eastmohan/keyboard/BOM.csv

KTT Kang White V3 Switches (70) | 1 | $18.53 | Aliexpress | https://www.aliexpress.us/item/3256805881801670.html?curPageLogUid=GlRH5qOW1IWp
1N4148 Diodes | 1 | $1.33 | Aliexpress | https://www.aliexpress.us/item/2255800939822415.html?curPageLogUid=RZOBB0uZmJXu
Keycap Stabilizers | 1 | $7.93 | Aliexpress | https://www.aliexpress.us/item/3256811775590309.html?curPageLogUid=WieDBUcBWX8g
PCB | 1 | $20.00 | JLCPCB | https://trade.jlcpcb.com/checkout/payMethod/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
Cherry Style Keycaps (any) | 1 |  | various
Raspberry Pi Pico 2 | 1 | $5.00 | PiShop | https://www.pishop.us/product/raspberry-pi-pico-2/
