eastmohan/keyboard/CAD/keyboard_assembled.step

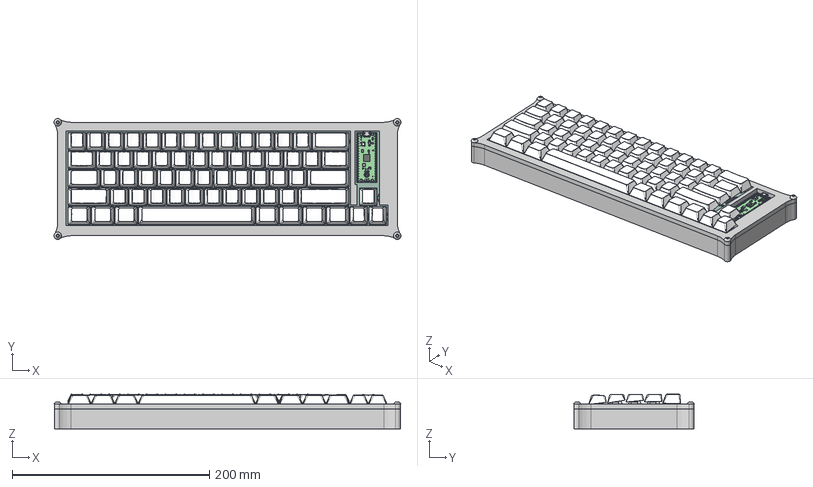
[picture p1: CAD file, 2026-10-19]
CAD/keyboard_assembled.step
351.8 x 122.5 x 35.2 mm
BHSBHCS ASME B18.3.4M - M4 x 0.7 x 25 Steel Grade 2 Plain x 4
FOEI - M3 X 5.74 Stainless Steel Plain x 4
