eastmohan/keyboard/CAD/Source Files/raspberry_pico_2.step

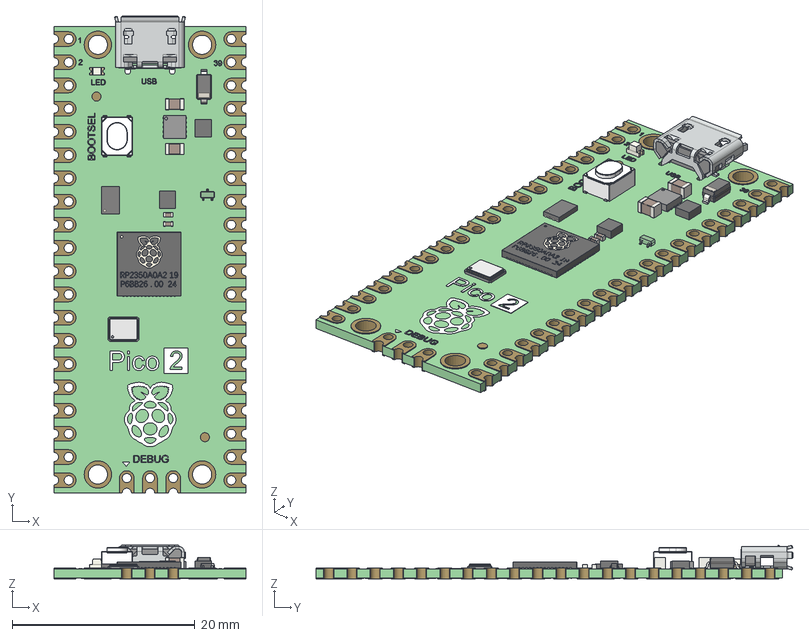
[picture p2: CAD file, 2026-10-19]
CAD/Source Files/raspberry_pico_2.step
21.0 x 52.1 x 3.70 mm
PCB
castel_hole x 40
castel_hole001 x 3
mounting_pad x 4
TP_noname001
test_point_round001
shield
socket_housing
socket_plate
terminal
terminal001
terminal002
terminal003
terminal004
LFXTAL055299Reel
LFXTAL055299Reel001
LFXTAL055299Reel002
LFXTAL055299Reel003
LFXTAL055299Reel004
LFXTAL055299Reel005
LFXTAL055299Reel006
LFXTAL055299Reel007
tactile_switch
Text_debug
fleche_debug
text_Pico
2_on_white
Text_led
Text_usb
Text_BOOTSEL
Text_1
Text_l2
Text_39
Scale003
Scale
ShapeString001
ShapeString002
ShapeString003
ShapeString004
ShapeString005
ShapeString006
ShapeString007
ShapeString008
ShapeString009
ShapeString010
ShapeString011
ShapeString
ShapeString013
ShapeString014
ShapeString015
ShapeString016
ShapeString017
ShapeString018
ShapeString019
ShapeString020
ShapeString021
ShapeString022
ShapeString023
D_SOD-123
ThermalPin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
