eastmohan/keyboard/CAD/Source Files/CHERRYMX CAD_CAM KEYCAPS.stp

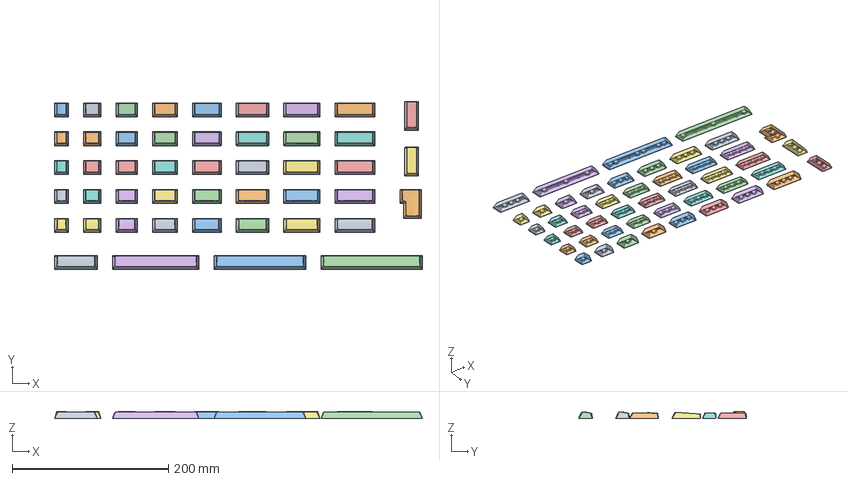
[picture p3: CAD file, 2026-10-19]
CAD/Source Files/CHERRYMX CAD_CAM KEYCAPS.stp
471.6 x 215.6 x 9.30 mm
