eastmohan/keyboard/CAD/top_plate.stl

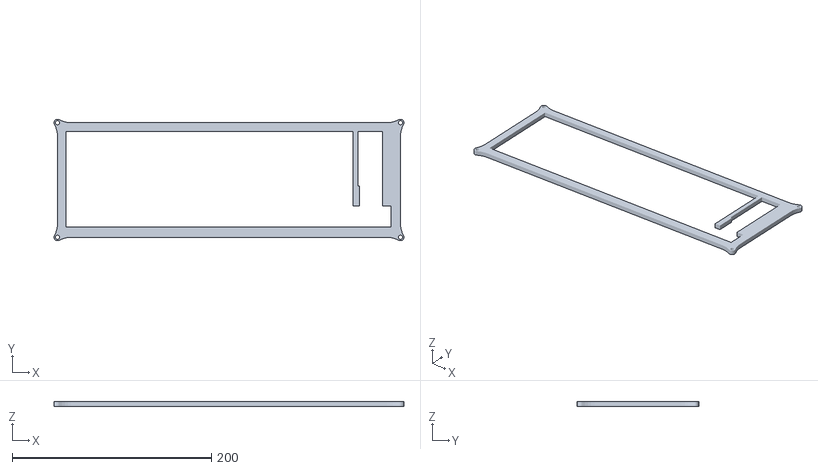
[picture p4: CAD file, 2026-10-19]
CAD/top_plate.stl
351.2 x 121.9 x 5.00
