eastmohan/keyboard/CAD/case_bottom.stl

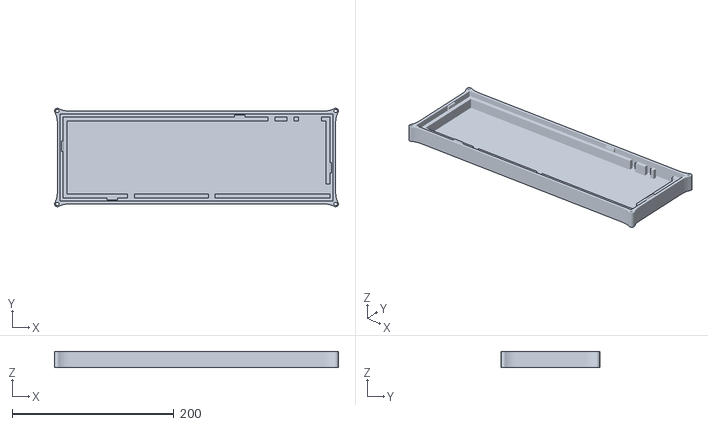
[picture p5: CAD file, 2026-10-19]
CAD/case_bottom.stl
351.2 x 121.9 x 20.2
