eastmohan/keyboard/CAD/keyboard_60.step

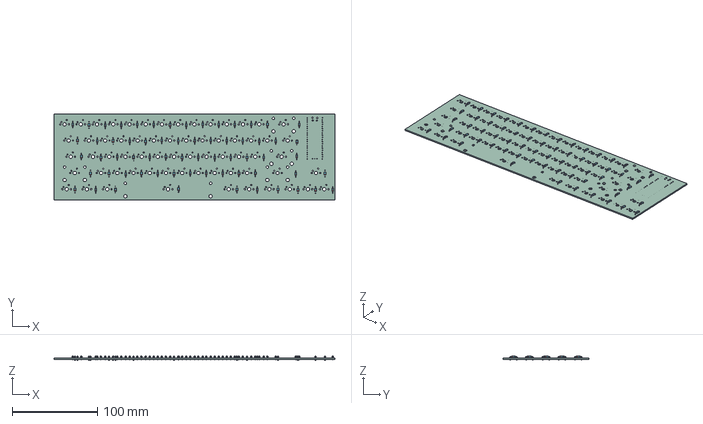
[picture p6: CAD file, 2026-10-13]
CAD/keyboard_60.step
330.0 x 100.8 x 5.01 mm
D_DO-35_SOD27_P7.62mm_Horizontal x 64
key7201_PCB
