eastmohan/keyboard/PCB/Project Files/keyboard_60.kicad_pcb

## KiCad design PCB/Project Files/keyboard_60.kicad_pcb (2026-10-12)

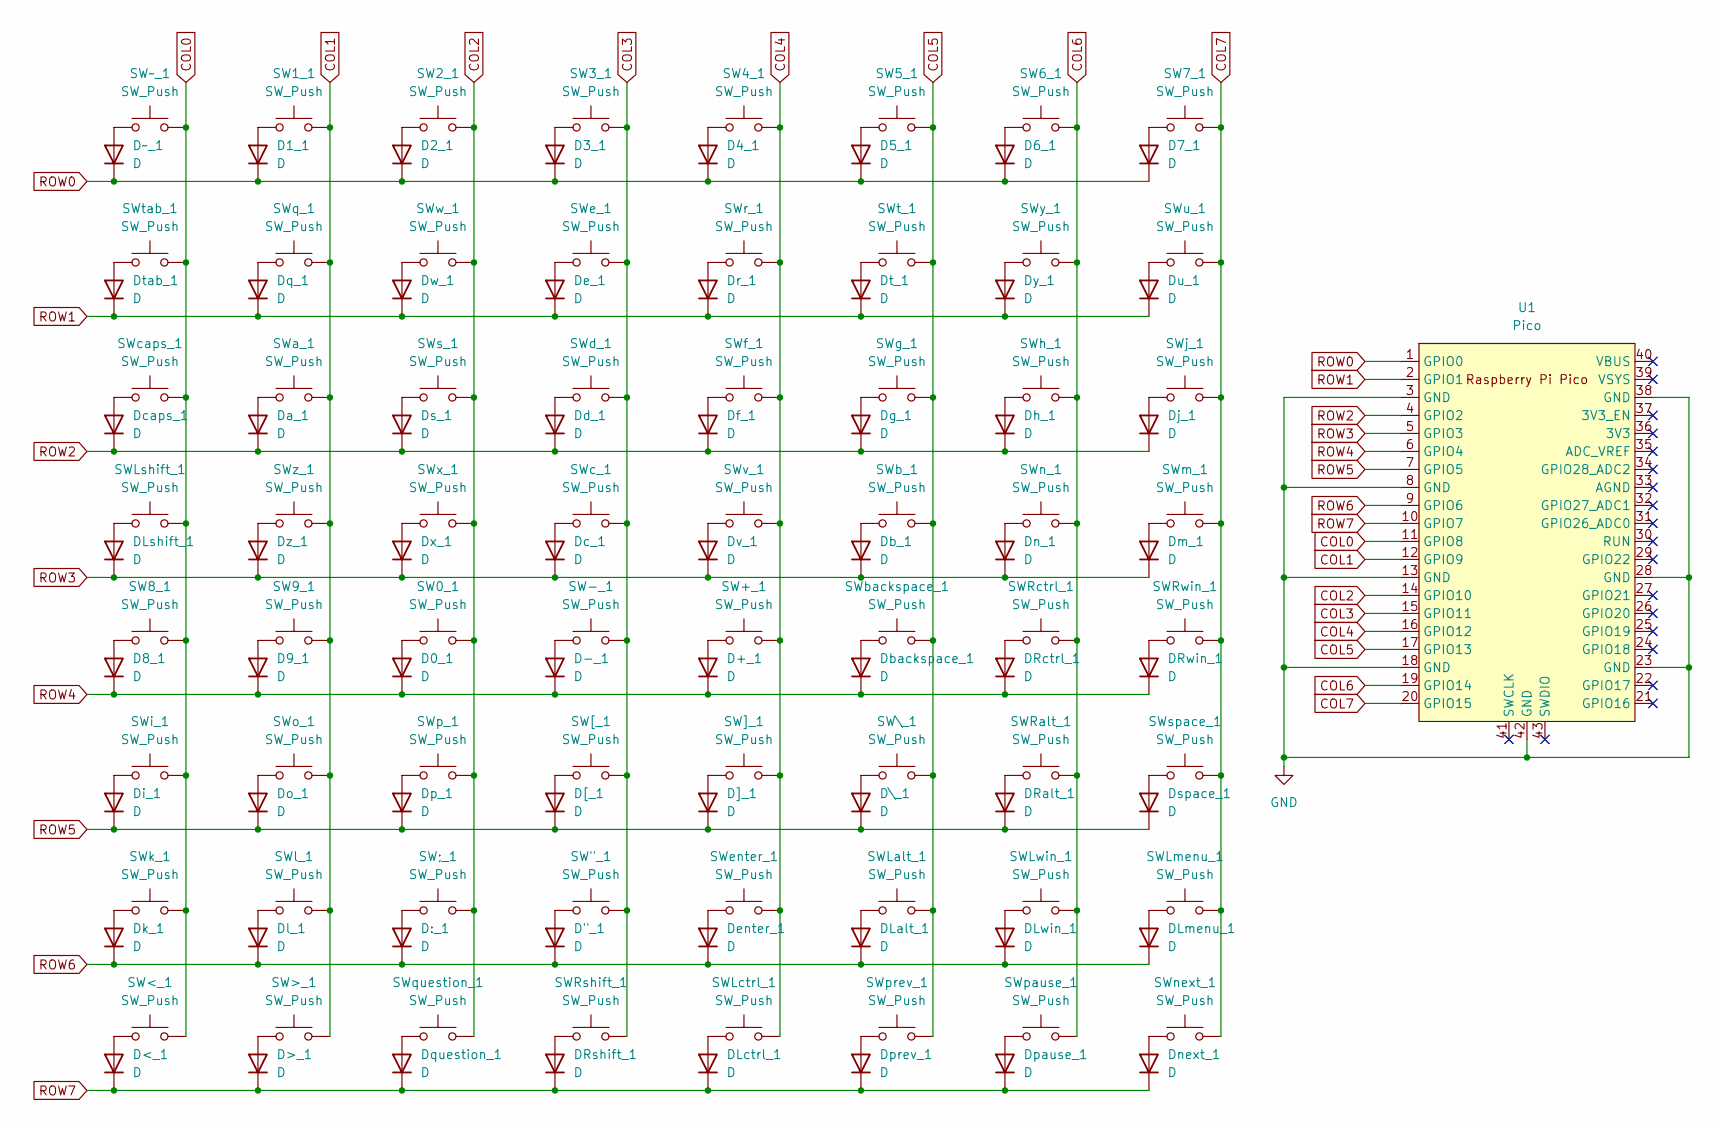
[picture p7: schematic keyboard_60.kicad_sch]

Parts:
D0_1, D1_1, D2_1, D3_1, D4_1, D5_1, D6_1, D7_1, D8_1, D9_1: D; D_DO-35_SOD27_P7.62mm_Horizontal
D"_1: D; D_DO-35_SOD27_P7.62mm_Horizontal
D+_1: D; D_DO-35_SOD27_P7.62mm_Horizontal
D-_1: D; D_DO-35_SOD27_P7.62mm_Horizontal
D:_1: D; D_DO-35_SOD27_P7.62mm_Horizontal
D<_1: D; D_DO-35_SOD27_P7.62mm_Horizontal
D>_1: D; D_DO-35_SOD27_P7.62mm_Horizontal
DLalt_1: D; D_DO-35_SOD27_P7.62mm_Horizontal
DLctrl_1: D; D_DO-35_SOD27_P7.62mm_Horizontal
DLmenu_1: D; D_DO-35_SOD27_P7.62mm_Horizontal
DLshift_1: D; D_DO-35_SOD27_P7.62mm_Horizontal
DLwin_1: D; D_DO-35_SOD27_P7.62mm_Horizontal
DRalt_1: D; D_DO-35_SOD27_P7.62mm_Horizontal
DRctrl_1: D; D_DO-35_SOD27_P7.62mm_Horizontal
DRshift_1: D; D_DO-35_SOD27_P7.62mm_Horizontal
DRwin_1: D; D_DO-35_SOD27_P7.62mm_Horizontal
D[_1: D; D_DO-35_SOD27_P7.62mm_Horizontal
D\_1: D; D_DO-35_SOD27_P7.62mm_Horizontal
D]_1: D; D_DO-35_SOD27_P7.62mm_Horizontal
Da_1: D; D_DO-35_SOD27_P7.62mm_Horizontal
Db_1: D; D_DO-35_SOD27_P7.62mm_Horizontal
Dbackspace_1: D; D_DO-35_SOD27_P7.62mm_Horizontal
Dc_1: D; D_DO-35_SOD27_P7.62mm_Horizontal
Dcaps_1: D; D_DO-35_SOD27_P7.62mm_Horizontal
Dd_1: D; D_DO-35_SOD27_P7.62mm_Horizontal
De_1: D; D_DO-35_SOD27_P7.62mm_Horizontal
Denter_1: D; D_DO-35_SOD27_P7.62mm_Horizontal
Df_1: D; D_DO-35_SOD27_P7.62mm_Horizontal
Dg_1: D; D_DO-35_SOD27_P7.62mm_Horizontal
Dh_1: D; D_DO-35_SOD27_P7.62mm_Horizontal
Di_1: D; D_DO-35_SOD27_P7.62mm_Horizontal
Dj_1: D; D_DO-35_SOD27_P7.62mm_Horizontal
Dk_1: D; D_DO-35_SOD27_P7.62mm_Horizontal
Dl_1: D; D_DO-35_SOD27_P7.62mm_Horizontal
Dm_1: D; D_DO-35_SOD27_P7.62mm_Horizontal
Dn_1: D; D_DO-35_SOD27_P7.62mm_Horizontal
Dnext_1: D; D_DO-35_SOD27_P7.62mm_Horizontal
Do_1: D; D_DO-35_SOD27_P7.62mm_Horizontal
Dp_1: D; D_DO-35_SOD27_P7.62mm_Horizontal
Dpause_1: D; D_DO-35_SOD27_P7.62mm_Horizontal
Dprev_1: D; D_DO-35_SOD27_P7.62mm_Horizontal
Dq_1: D; D_DO-35_SOD27_P7.62mm_Horizontal
Dquestion_1: D; D_DO-35_SOD27_P7.62mm_Horizontal
Dr_1: D; D_DO-35_SOD27_P7.62mm_Horizontal
Ds_1: D; D_DO-35_SOD27_P7.62mm_Horizontal
Dspace_1: D; D_DO-35_SOD27_P7.62mm_Horizontal
Dt_1: D; D_DO-35_SOD27_P7.62mm_Horizontal
Dtab_1: D; D_DO-35_SOD27_P7.62mm_Horizontal
Du_1: D; D_DO-35_SOD27_P7.62mm_Horizontal
Dv_1: D; D_DO-35_SOD27_P7.62mm_Horizontal
Dw_1: D; D_DO-35_SOD27_P7.62mm_Horizontal
Dx_1: D; D_DO-35_SOD27_P7.62mm_Horizontal
Dy_1: D; D_DO-35_SOD27_P7.62mm_Horizontal
Dz_1: D; D_DO-35_SOD27_P7.62mm_Horizontal
D~_1: D; D_DO-35_SOD27_P7.62mm_Horizontal
SW0_1, SW1_1, SW2_1, SW3_1, SW4_1, SW5_1, SW6_1, SW7_1, SW8_1, SW9_1: SW_Push; SW_Cherry_MX_1.00u_PCB
SW"_1: SW_Push; SW_Cherry_MX_1.00u_PCB
SW+_1: SW_Push; SW_Cherry_MX_1.00u_PCB
SW-_1: SW_Push; SW_Cherry_MX_1.00u_PCB
SW;_1: SW_Push; SW_Cherry_MX_1.00u_PCB
SW<_1: SW_Push; SW_Cherry_MX_1.00u_PCB
SW>_1: SW_Push; SW_Cherry_MX_1.00u_PCB
SWLalt_1: SW_Push; SW_Cherry_MX_1.25u_PCB
SWLctrl_1: SW_Push; SW_Cherry_MX_1.25u_PCB
SWLmenu_1: SW_Push; SW_Cherry_MX_1.25u_PCB
SWLshift_1: SW_Push; SW_Cherry_MX_2.75u_PCB
SWLwin_1: SW_Push; SW_Cherry_MX_1.25u_PCB
SWRalt_1: SW_Push; SW_Cherry_MX_1.25u_PCB
SWRctrl_1: SW_Push; SW_Cherry_MX_1.25u_PCB
SWRshift_1: SW_Push; SW_Cherry_MX_2.25u_PCB
SWRwin_1: SW_Push; SW_Cherry_MX_1.25u_PCB
SW[_1: SW_Push; SW_Cherry_MX_1.00u_PCB
SW\_1: SW_Push; SW_Cherry_MX_1.00u_PCB
SW]_1: SW_Push; SW_Cherry_MX_1.00u_PCB
SWa_1: SW_Push; SW_Cherry_MX_1.00u_PCB
SWb_1: SW_Push; SW_Cherry_MX_1.00u_PCB
SWbackspace_1: SW_Push; SW_Cherry_MX_2.00u_PCB
SWc_1: SW_Push; SW_Cherry_MX_1.00u_PCB
SWcaps_1: SW_Push; SW_Cherry_MX_1.75u_PCB
SWd_1: SW_Push; SW_Cherry_MX_1.00u_PCB
SWe_1: SW_Push; SW_Cherry_MX_1.00u_PCB
SWenter_1: SW_Push; SW_Cherry_MX_2.25u_PCB
SWf_1: SW_Push; SW_Cherry_MX_1.00u_PCB
SWg_1: SW_Push; SW_Cherry_MX_1.00u_PCB
SWh_1: SW_Push; SW_Cherry_MX_1.00u_PCB
SWi_1: SW_Push; SW_Cherry_MX_1.00u_PCB
SWj_1: SW_Push; SW_Cherry_MX_1.00u_PCB
SWk_1: SW_Push; SW_Cherry_MX_1.00u_PCB
SWl_1: SW_Push; SW_Cherry_MX_1.00u_PCB
SWm_1: SW_Push; SW_Cherry_MX_1.00u_PCB
SWn_1: SW_Push; SW_Cherry_MX_1.00u_PCB
SWnext_1: SW_Push; SW_Cherry_MX_1.00u_PCB
SWo_1: SW_Push; SW_Cherry_MX_1.00u_PCB
SWp_1: SW_Push; SW_Cherry_MX_1.00u_PCB
SWpause_1: SW_Push; SW_Cherry_MX_1.00u_PCB
SWprev_1: SW_Push; SW_Cherry_MX_1.00u_PCB
SWq_1: SW_Push; SW_Cherry_MX_1.00u_PCB
SWquestion_1: SW_Push; SW_Cherry_MX_1.00u_PCB
SWr_1: SW_Push; SW_Cherry_MX_1.00u_PCB
SWs_1: SW_Push; SW_Cherry_MX_1.00u_PCB
SWspace_1: SW_Push; SW_Cherry_MX_6.25u_PCB
SWt_1: SW_Push; SW_Cherry_MX_1.00u_PCB
SWtab_1: SW_Push; SW_Cherry_MX_1.50u_PCB
SWu_1: SW_Push; SW_Cherry_MX_1.00u_PCB
SWv_1: SW_Push; SW_Cherry_MX_1.00u_PCB
SWw_1: SW_Push; SW_Cherry_MX_1.00u_PCB
SWx_1: SW_Push; SW_Cherry_MX_1.00u_PCB
SWy_1: SW_Push; SW_Cherry_MX_1.00u_PCB
SWz_1: SW_Push; SW_Cherry_MX_1.00u_PCB
SW~_1: SW_Push; SW_Cherry_MX_1.00u_PCB
U1: Pico; RPi_Pico_SMD_TH

Connections:
COL0: SW8_1.2, SW<_1.2, SWLshift_1.2, SWcaps_1.2, SWi_1.2, SWk_1.2, SWtab_1.2, SW~_1.2, U1.11 (GPIO8)
COL1: SW1_1.2, SW9_1.2, SW>_1.2, SWa_1.2, SWl_1.2, SWo_1.2, SWq_1.2, SWz_1.2, U1.12 (GPIO9)
COL2: SW0_1.2, SW2_1.2, SW;_1.2, SWp_1.2, SWquestion_1.2, SWs_1.2, SWw_1.2, SWx_1.2, U1.14 (GPIO10)
COL3: SW3_1.2, SW"_1.2, SW-_1.2, SWRshift_1.2, SW[_1.2, SWc_1.2, SWd_1.2, SWe_1.2, U1.15 (GPIO11)
COL4: SW4_1.2, SW+_1.2, SWLctrl_1.2, SW]_1.2, SWenter_1.2, SWf_1.2, SWr_1.2, SWv_1.2, U1.16 (GPIO12)
COL5: SW5_1.2, SWLalt_1.2, SW\_1.2, SWb_1.2, SWbackspace_1.2, SWg_1.2, SWprev_1.2, SWt_1.2, U1.17 (GPIO13)
COL6: SW6_1.2, SWLwin_1.2, SWRalt_1.2, SWRctrl_1.2, SWh_1.2, SWn_1.2, SWpause_1.2, SWy_1.2, U1.19 (GPIO14)
COL7: SW7_1.2, SWLmenu_1.2, SWRwin_1.2, SWj_1.2, SWm_1.2, SWnext_1.2, SWspace_1.2, SWu_1.2, U1.20 (GPIO15)
GND: U1.3 (GND), U1.8 (GND), U1.13 (GND), U1.18 (GND), U1.23 (GND), U1.28 (GND), U1.38 (GND), U1.42 (GND)
unnamed: D0_1.2 (A), SW0_1.1
unnamed: D1_1.2 (A), SW1_1.1
unnamed: D2_1.2 (A), SW2_1.1
unnamed: D3_1.2 (A), SW3_1.1
unnamed: D4_1.2 (A), SW4_1.1
unnamed: D5_1.2 (A), SW5_1.1
unnamed: D6_1.2 (A), SW6_1.1
unnamed: D7_1.2 (A), SW7_1.1
unnamed: D8_1.2 (A), SW8_1.1
unnamed: D9_1.2 (A), SW9_1.1
unnamed: D"_1.2 (A), SW"_1.1
unnamed: D+_1.2 (A), SW+_1.1
unnamed: D-_1.2 (A), SW-_1.1
unnamed: D:_1.2 (A), SW;_1.1
unnamed: D<_1.2 (A), SW<_1.1
unnamed: D>_1.2 (A), SW>_1.1
unnamed: DLalt_1.2 (A), SWLalt_1.1
unnamed: DLctrl_1.2 (A), SWLctrl_1.1
unnamed: DLmenu_1.2 (A), SWLmenu_1.1
unnamed: DLshift_1.2 (A), SWLshift_1.1
unnamed: DLwin_1.2 (A), SWLwin_1.1
unnamed: DRalt_1.2 (A), SWRalt_1.1
unnamed: DRctrl_1.2 (A), SWRctrl_1.1
unnamed: DRshift_1.2 (A), SWRshift_1.1
unnamed: DRwin_1.2 (A), SWRwin_1.1
unnamed: D[_1.2 (A), SW[_1.1
unnamed: D\_1.2 (A), SW\_1.1
unnamed: D]_1.2 (A), SW]_1.1
unnamed: Da_1.2 (A), SWa_1.1
unnamed: Db_1.2 (A), SWb_1.1
unnamed: Dbackspace_1.2 (A), SWbackspace_1.1
unnamed: Dc_1.2 (A), SWc_1.1
unnamed: Dcaps_1.2 (A), SWcaps_1.1
unnamed: Dd_1.2 (A), SWd_1.1
unnamed: De_1.2 (A), SWe_1.1
unnamed: Denter_1.2 (A), SWenter_1.1
unnamed: Df_1.2 (A), SWf_1.1
unnamed: Dg_1.2 (A), SWg_1.1
unnamed: Dh_1.2 (A), SWh_1.1
unnamed: Di_1.2 (A), SWi_1.1
unnamed: Dj_1.2 (A), SWj_1.1
unnamed: Dk_1.2 (A), SWk_1.1
unnamed: Dl_1.2 (A), SWl_1.1
unnamed: Dm_1.2 (A), SWm_1.1
unnamed: Dn_1.2 (A), SWn_1.1
unnamed: Dnext_1.2 (A), SWnext_1.1
unnamed: Do_1.2 (A), SWo_1.1
unnamed: Dp_1.2 (A), SWp_1.1
unnamed: Dpause_1.2 (A), SWpause_1.1
unnamed: Dprev_1.2 (A), SWprev_1.1
unnamed: Dq_1.2 (A), SWq_1.1
unnamed: Dquestion_1.2 (A), SWquestion_1.1
unnamed: Dr_1.2 (A), SWr_1.1
unnamed: Ds_1.2 (A), SWs_1.1
unnamed: Dspace_1.2 (A), SWspace_1.1
unnamed: Dt_1.2 (A), SWt_1.1
unnamed: Dtab_1.2 (A), SWtab_1.1
unnamed: Du_1.2 (A), SWu_1.1
unnamed: Dv_1.2 (A), SWv_1.1
unnamed: Dw_1.2 (A), SWw_1.1
unnamed: Dx_1.2 (A), SWx_1.1
unnamed: Dy_1.2 (A), SWy_1.1
unnamed: Dz_1.2 (A), SWz_1.1
unnamed: D~_1.2 (A), SW~_1.1
ROW0: D1_1.1 (K), D2_1.1 (K), D3_1.1 (K), D4_1.1 (K), D5_1.1 (K), D6_1.1 (K), D7_1.1 (K), D~_1.1 (K), U1.1 (GPIO0)
ROW1: De_1.1 (K), Dq_1.1 (K), Dr_1.1 (K), Dt_1.1 (K), Dtab_1.1 (K), Du_1.1 (K), Dw_1.1 (K), Dy_1.1 (K), U1.2 (GPIO1)
ROW2: Da_1.1 (K), Dcaps_1.1 (K), Dd_1.1 (K), Df_1.1 (K), Dg_1.1 (K), Dh_1.1 (K), Dj_1.1 (K), Ds_1.1 (K), U1.4 (GPIO2)
ROW3: DLshift_1.1 (K), Db_1.1 (K), Dc_1.1 (K), Dm_1.1 (K), Dn_1.1 (K), Dv_1.1 (K), Dx_1.1 (K), Dz_1.1 (K), U1.5 (GPIO3)
ROW4: D0_1.1 (K), D8_1.1 (K), D9_1.1 (K), D+_1.1 (K), D-_1.1 (K), DRctrl_1.1 (K), DRwin_1.1 (K), Dbackspace_1.1 (K), U1.6 (GPIO4)
ROW5: DRalt_1.1 (K), D[_1.1 (K), D\_1.1 (K), D]_1.1 (K), Di_1.1 (K), Do_1.1 (K), Dp_1.1 (K), Dspace_1.1 (K), U1.7 (GPIO5)
ROW6: D"_1.1 (K), D:_1.1 (K), DLalt_1.1 (K), DLmenu_1.1 (K), DLwin_1.1 (K), Denter_1.1 (K), Dk_1.1 (K), Dl_1.1 (K), U1.9 (GPIO6)
ROW7: D<_1.1 (K), D>_1.1 (K), DLctrl_1.1 (K), DRshift_1.1 (K), Dnext_1.1 (K), Dpause_1.1 (K), Dprev_1.1 (K), Dquestion_1.1 (K), U1.10 (GPIO7)

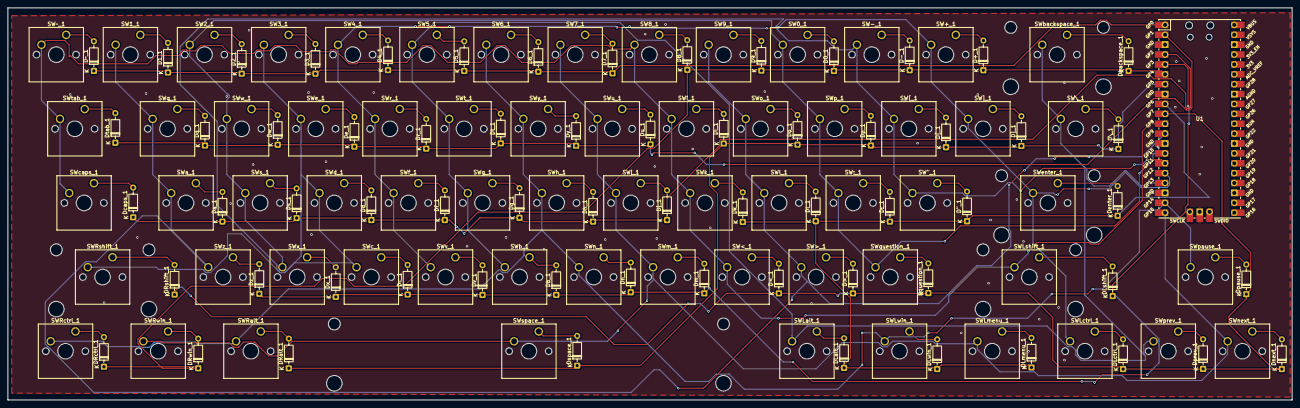
[picture p8: board keyboard_60.kicad_pcb from above]

Board: 2 copper layers, 330.0 x 100.8 mm, 129 parts (0 on the bottom side), 81 nets.
