eastmohan/keyboard/(commit log)

2026-10-12 Added PCB Files
2026-10-13 Update README with assembly instructions and images
    Added assembly instructions and images for the keyboard.
2026-10-19 Added CAD
2026-10-19 Update README to remove pending project details
    Removed mention of upcoming firmware and CAD files.
